DanielCusi/Aurelia-robotics-PCB/Llibreries/TMP235/README.md

[TMP235 (DBZ)](https://vendor.ultralibrarian.com/TI/embedded/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)
