DanielCusi/Aurelia-robotics-PCB/Llibreries/TPS25730D/README.md

[TPS25730DREFR](https://vendor.ultralibrarian.com/TI/embedded/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)
