DanielCusi/Aurelia-robotics-PCB/Llibreries/ul_DRV8873HPWPR/README.md

[DRV8873HPWPR](https://vendor.ultralibrarian.com/TI/embedded/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)
