DanielCusi/Aurelia-robotics-PCB/Llibreries/ul_TCA6408APWR/README.md

[TCA6408APWR](https://vendor.ultralibrarian.com/TI/embedded/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)
