DanielCusi/Aurelia-robotics-PCB/Llibreries/ul_TPS54531DDA/README.md

[TPS54531DDA](https://vendor.ultralibrarian.com/TI/embedded/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)
