DanielCusi/Aurelia-robotics-PCB/Llibreries/ul_TPS563300DRLR/README.md

[TPS563300DRLR](https://vendor.ultralibrarian.com/TI/embedded/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)
