DanielCusi/Aurelia-robotics-PCB/Alimentacio.kicad_sch

## KiCad design Alimentacio.kicad_sch (2024-10-28)

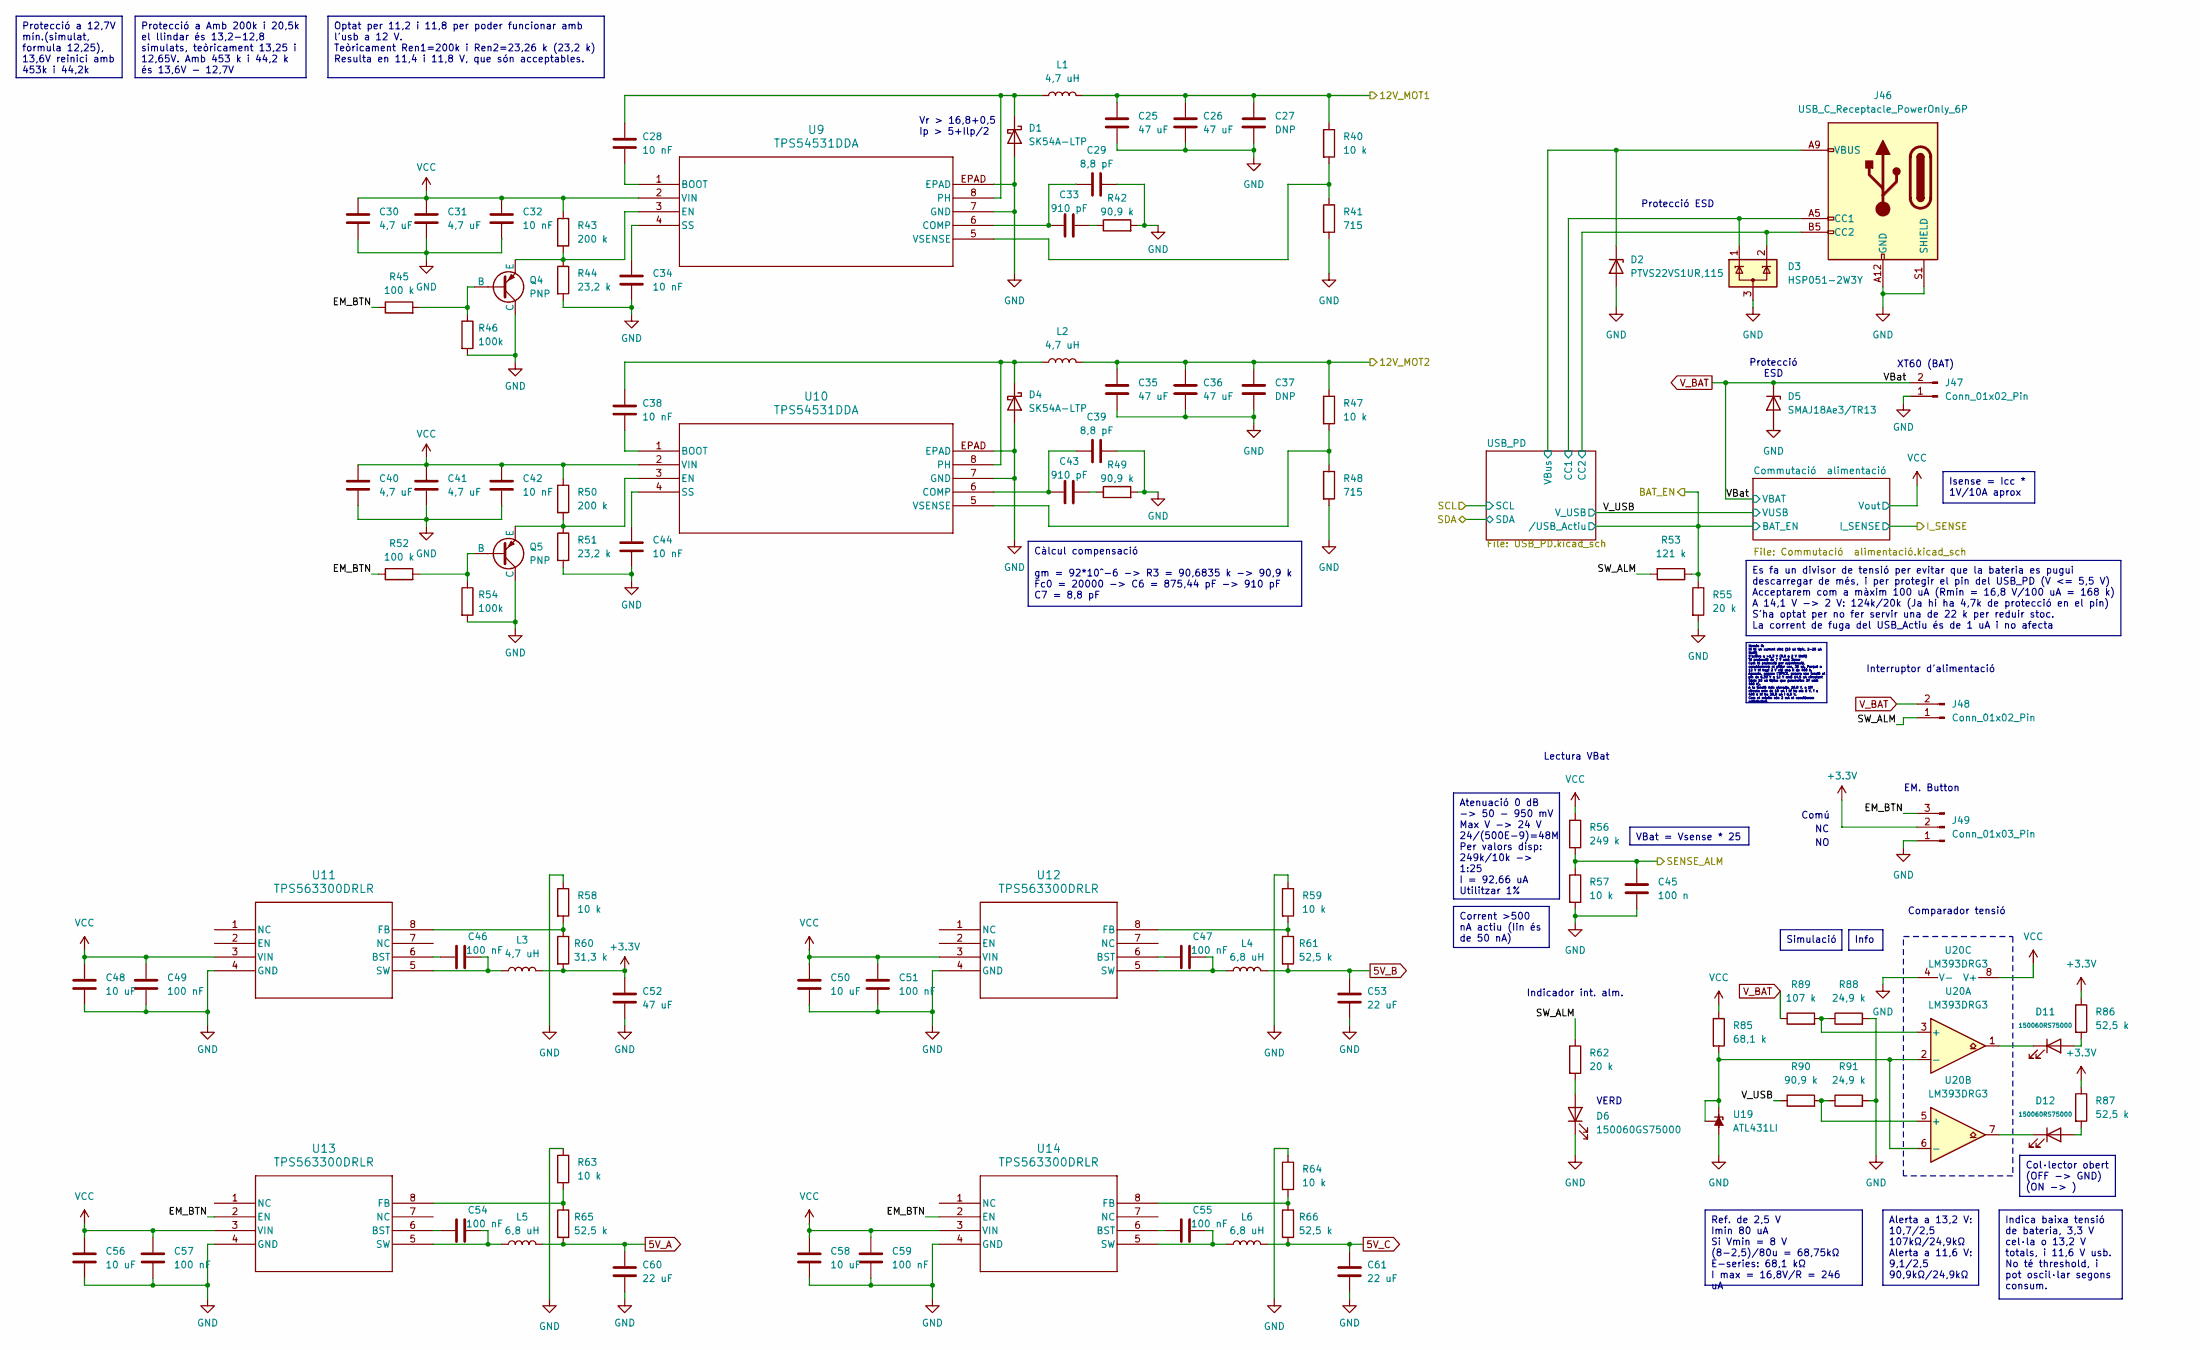
[picture p1: schematic Alimentacio.kicad_sch]

Parts:
C25, C26, C35, C36, C52: 47 uF; C_1210_3225Metric_Pad1.33x2.70mm_HandSolder
C27, C37: DNP; C_1210_3225Metric_Pad1.33x2.70mm_HandSolder
C28, C32, C34, C38, C42, C44: 10 nF; C_0603_1608Metric_Pad1.08x0.95mm_HandSolder
C29, C39: 8,8 pF; C_0603_1608Metric_Pad1.08x0.95mm_HandSolder
C30, C31, C40, C41: 4,7 uF; C_0603_1608Metric_Pad1.08x0.95mm_HandSolder
C33, C43: 910 pF; C_0603_1608Metric_Pad1.08x0.95mm_HandSolder
C45: 100 n; C_0603_1608Metric_Pad1.08x0.95mm_HandSolder
C46, C47, C49, C51, C54, C55, C57, C59: 100 nF; C_0603_1608Metric_Pad1.08x0.95mm_HandSolder
C48, C50, C56, C58: 10 uF; C_0603_1608Metric_Pad1.08x0.95mm_HandSolder
C53, C60, C61: 22 uF; C_0805_2012Metric_Pad1.18x1.45mm_HandSolder
D1, D4: SK54A-LTP; D_SMA
D2: PTVS22VS1UR,115; Nexperia_CFP3_SOD-123W
D3: HSP051-2W3Y; SOT-323_SC-70_Handsoldering
D5: SMAJ18Ae3/TR13; D_SMA_Handsoldering
D6: 150060GS75000; LED_0603_1608Metric_Pad1.05x0.95mm_HandSolder
D11, D12: 150060RS75000; LED_0603_1608Metric_Pad1.05x0.95mm_HandSolder
J46: USB_C_Receptacle_PowerOnly_6P; USB_C_6_DEALON
J47: Conn_01x02_Pin; AMASS_XT60PW-M_1x02_P7.20mm_Horizontal
J48: Conn_01x02_Pin; JST_PH_B2B-PH-K_1x02_P2.00mm_Vertical
J49: Conn_01x03_Pin; JST_PH_B3B-PH-K_1x03_P2.00mm_Vertical
L1, L2, L3: 4,7 uH; INDPM7166X300N
L4, L5, L6: 6,8 uH; INDPM7166X300N
Q4, Q5: PNP; SOT-23
R40, R47, R57, R58, R59, R63, R64: 10 k; R_0603_1608Metric_Pad0.98x0.95mm_HandSolder
R41, R48: 715; R_0603_1608Metric_Pad0.98x0.95mm_HandSolder
R42, R49, R90: 90,9 k; R_0603_1608Metric_Pad0.98x0.95mm_HandSolder
R43, R50: 200 k; R_0603_1608Metric_Pad0.98x0.95mm_HandSolder
R44, R51: 23,2 k; R_0603_1608Metric_Pad0.98x0.95mm_HandSolder
R45, R52: 100 k; R_0603_1608Metric_Pad0.98x0.95mm_HandSolder
R46, R54: 100k; R_0603_1608Metric_Pad0.98x0.95mm_HandSolder
R53: 121 k; R_0603_1608Metric_Pad0.98x0.95mm_HandSolder
R55, R62: 20 k; R_0603_1608Metric_Pad0.98x0.95mm_HandSolder
R56: 249 k; R_0603_1608Metric_Pad0.98x0.95mm_HandSolder
R60: 31,3 k; R_0603_1608Metric_Pad0.98x0.95mm_HandSolder
R61, R65, R66, R86, R87: 52,5 k; R_0603_1608Metric_Pad0.98x0.95mm_HandSolder
R85: 68,1 k; R_0603_1608Metric_Pad0.98x0.95mm_HandSolder
R88, R91: 24,9 k; R_0603_1608Metric_Pad0.98x0.95mm_HandSolder
R89: 107 k; R_0603_1608Metric_Pad0.98x0.95mm_HandSolder
U9, U10: TPS54531DDA; DDA8_3P1X2P4_TEX
U11, U12, U13, U14: TPS563300DRLR; SOT5X3-8_DRL_TEX
U19: ATL431LI; SOT-23
U20: LM393DRG3; SOIC-8_3.9x4.9mm_P1.27mm

Connections:
5V_A: C60.2, L5.2, R65.2
5V_B: C53.2, L4.2, R61.2
5V_C: C61.2, L6.2, R66.2
12V_MOT1: C25.1, C26.1, C27.1, L1.2, R40.1
12V_MOT2: C35.1, C36.1, C37.1, L2.2, R47.1
+3.3V: C52.2, J49.2, L3.2, R60.2, R86.1, R87.1
BAT_EN: R53.1, R55.1
CC1: D3.1 (K), J46.A5 (CC1)
CC2: D3.2 (K), J46.B5 (CC2)
EM_BTN: J49.3, R45.1, R52.1, U13.2 (EN), U14.2 (EN)
GND: C25.2, C26.2, C27.2, C29.2, C30.2, C31.2, C32.2, C34.2, C35.2, C36.2, C37.2, C39.2, C40.2, C41.2, C42.2, C44.2, C45.2, C48.2, C49.2, C50.2, C51.2, C52.1, C53.1, C56.2, C57.2, C58.2, C59.2, C60.1, C61.1, D1.2 (A), D2.2 (A), D3.3 (A), D4.2 (A), D5.2 (A), D6.1 (K), J46.A12 (GND), J46.B12 (GND), J46.S1 (SHIELD), J47.1, J49.1, Q4.1 (C), Q5.1 (C), R41.2, R42.2, R44.2, R46.2, R48.2, R49.2, R51.2, R54.2, R55.2, R57.2, R58.1, R59.1, R63.1, R64.1, R88.2, R91.2, U9.7 (GND), U9.EPAD, U10.7 (GND), U10.EPAD, U11.4 (GND), U12.4 (GND), U13.4 (GND), U14.4 (GND), U19.3 (A), U20.4 (V-)
unnamed: C28.1, D1.1 (K), L1.1, U9.8 (PH)
unnamed: C28.2, U9.1 (BOOT)
unnamed: C29.1, C33.1, U9.6 (COMP)
unnamed: C33.2, R42.1
unnamed: C34.1, U9.4 (SS)
unnamed: C38.1, D4.1 (K), L2.1, U10.8 (PH)
unnamed: C38.2, U10.1 (BOOT)
unnamed: C39.1, C43.1, U10.6 (COMP)
unnamed: C43.2, R49.1
unnamed: C44.1, U10.4 (SS)
unnamed: C46.1, U11.6 (BST)
unnamed: C46.2, L3.1, U11.5 (SW)
unnamed: C47.1, U12.6 (BST)
unnamed: C47.2, L4.1, U12.5 (SW)
unnamed: C54.1, U13.6 (BST)
unnamed: C54.2, L5.1, U13.5 (SW)
unnamed: C55.1, U14.6 (BST)
unnamed: C55.2, L6.1, U14.5 (SW)
unnamed: D6.2 (A), R62.2
unnamed: D11.1 (K), U20.1
unnamed: D11.2 (A), R86.2
unnamed: D12.1 (K), U20.7
unnamed: D12.2 (A), R87.2
unnamed: Q4.2 (B), R45.2, R46.1
unnamed: Q4.3 (E), R43.2, R44.1, U9.3 (EN)
unnamed: Q5.2 (B), R52.2, R54.1
unnamed: Q5.3 (E), R50.2, R51.1, U10.3 (EN)
unnamed: R40.2, R41.1, U9.5 (VSENSE)
unnamed: R47.2, R48.1, U10.5 (VSENSE)
unnamed: R58.2, R60.1, U11.8 (FB)
unnamed: R59.2, R61.1, U12.8 (FB)
unnamed: R63.2, R65.1, U13.8 (FB)
unnamed: R64.2, R66.1, U14.8 (FB)
unnamed: R85.2, U19.1 (K), U19.2 (REF), U20.2 (-), U20.6 (-)
unnamed: R88.1, R89.2, U20.3 (+)
unnamed: R90.2, R91.1, U20.5 (+)
SENSE_ALM: C45.1, R56.2, R57.1
SW_ALM: J48.1, R53.2, R62.1
VBus: D2.1 (K), J46.A9 (VBUS), J46.B9 (VBUS)
VCC: C30.1, C31.1, C32.1, C40.1, C41.1, C42.1, C48.1, C49.1, C50.1, C51.1, C56.1, C57.1, C58.1, C59.1, R43.1, R50.1, R56.1, R85.1, U9.2 (VIN), U10.2 (VIN), U11.3 (VIN), U12.3 (VIN), U13.3 (VIN), U14.3 (VIN), U20.8 (V+)
V_BAT: D5.1 (K), J47.2, J48.2, R89.1
V_USB: R90.1

Notes on the sheet:
Col·lector obert (OFF -> GND) (ON -> )
Indica baixa tensió de bateria, 3,3 V cel·la o 13,2 V totals, i 11,6 V usb. No té threshold, i pot oscil·lar segons consum.
Només R: IN té un current sink (10 uA típic, 2-25 uA límit) S'activa a >1,3 V (0,8 a 2 V límit) Té protecció de 7 V amb Zener Com té protecció per sobretensió, considerarem el pitjor cas, 25 uA. Perquè a 12 V hi hagi 2 V cal una R de 400 k. Aquesta, segons l'SPICE, genera una tensió al pin de 6,38 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
Protecció a Amb 200k i 20,5k el llindar és 13,2-12,8 simulats, teòricament 13,25 i 12,65V. Amb 453 k i 44,2 k és 13,6V - 12,7V
Es fa un divisor de tensió per evitar que la bateria es pugui descarregar de més, i per protegir el pin del USB_PD (V <= 5,5 V) Acceptarem com a màxim 100 uA (Rmin = 16,8 V/100 uA = 168 k) A 14,1 V -> 2 V: 124k/20k (Ja hi ha 4,7k de protecció en el pin) S'ha optat per no fer servir una de 22 k per 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
VBat = Vsense * 25
Optat per 11,2 i 11,8 per poder funcionar amb l'usb a 12 V. Teòricament Ren1=200k i Ren2=23,26 k (23,2 k) Resulta en 11,4 i 11,8 V, que són acceptables.
Isense = Icc * 1V/10A aprox
Protecció a 12,7V mín.(simulat, formula 12,25), 13,6V reinici amb 453k i 44,2k
Simulació
Atenuació 0 dB -> 50 - 950 mV Max V -> 24 V 24/(500E-9)=48M Per valors disp: 249k/10k -> 1:25 I = 92,66 uA Utilitzar 1%
Info
Ref. de 2,5 V Imin 80 uA Si Vmin = 8 V (8-2,5)/80u = 68,75kΩ E-series: 68,1 kΩ I max = 16,8V/R = 246 uA
Corrent >500 nA actiu (Iin és de 50 nA)
Alerta a 13,2 V: 10,7/2,5 107kΩ/24,9kΩ Alerta a 11,6 V: 9,1/2,5 90,9kΩ/24,9kΩ
Càlcul compensació gm = 92*10^-6 -> R3 = 90,6835 k -> 90,9 k Fc0 = 20000 -> C6 = 875,44 pF -> 910 pF C7 = 8,8 pF
Indicador int. alm.
XT60 (BAT)
Protecció ESD
EM. Button
Vr > 16,8+0,5 Ip > 5+Ilp/2
Protecció ESD
VERD
Comú
Lectura VBat
Comparador tensió
Interruptor d'alimentació
