DanielCusi/Aurelia-robotics-PCB/Aurelia-robotics-PCB.kicad_sch

## KiCad design Aurelia-robotics-PCB.kicad_sch (2024-10-28)

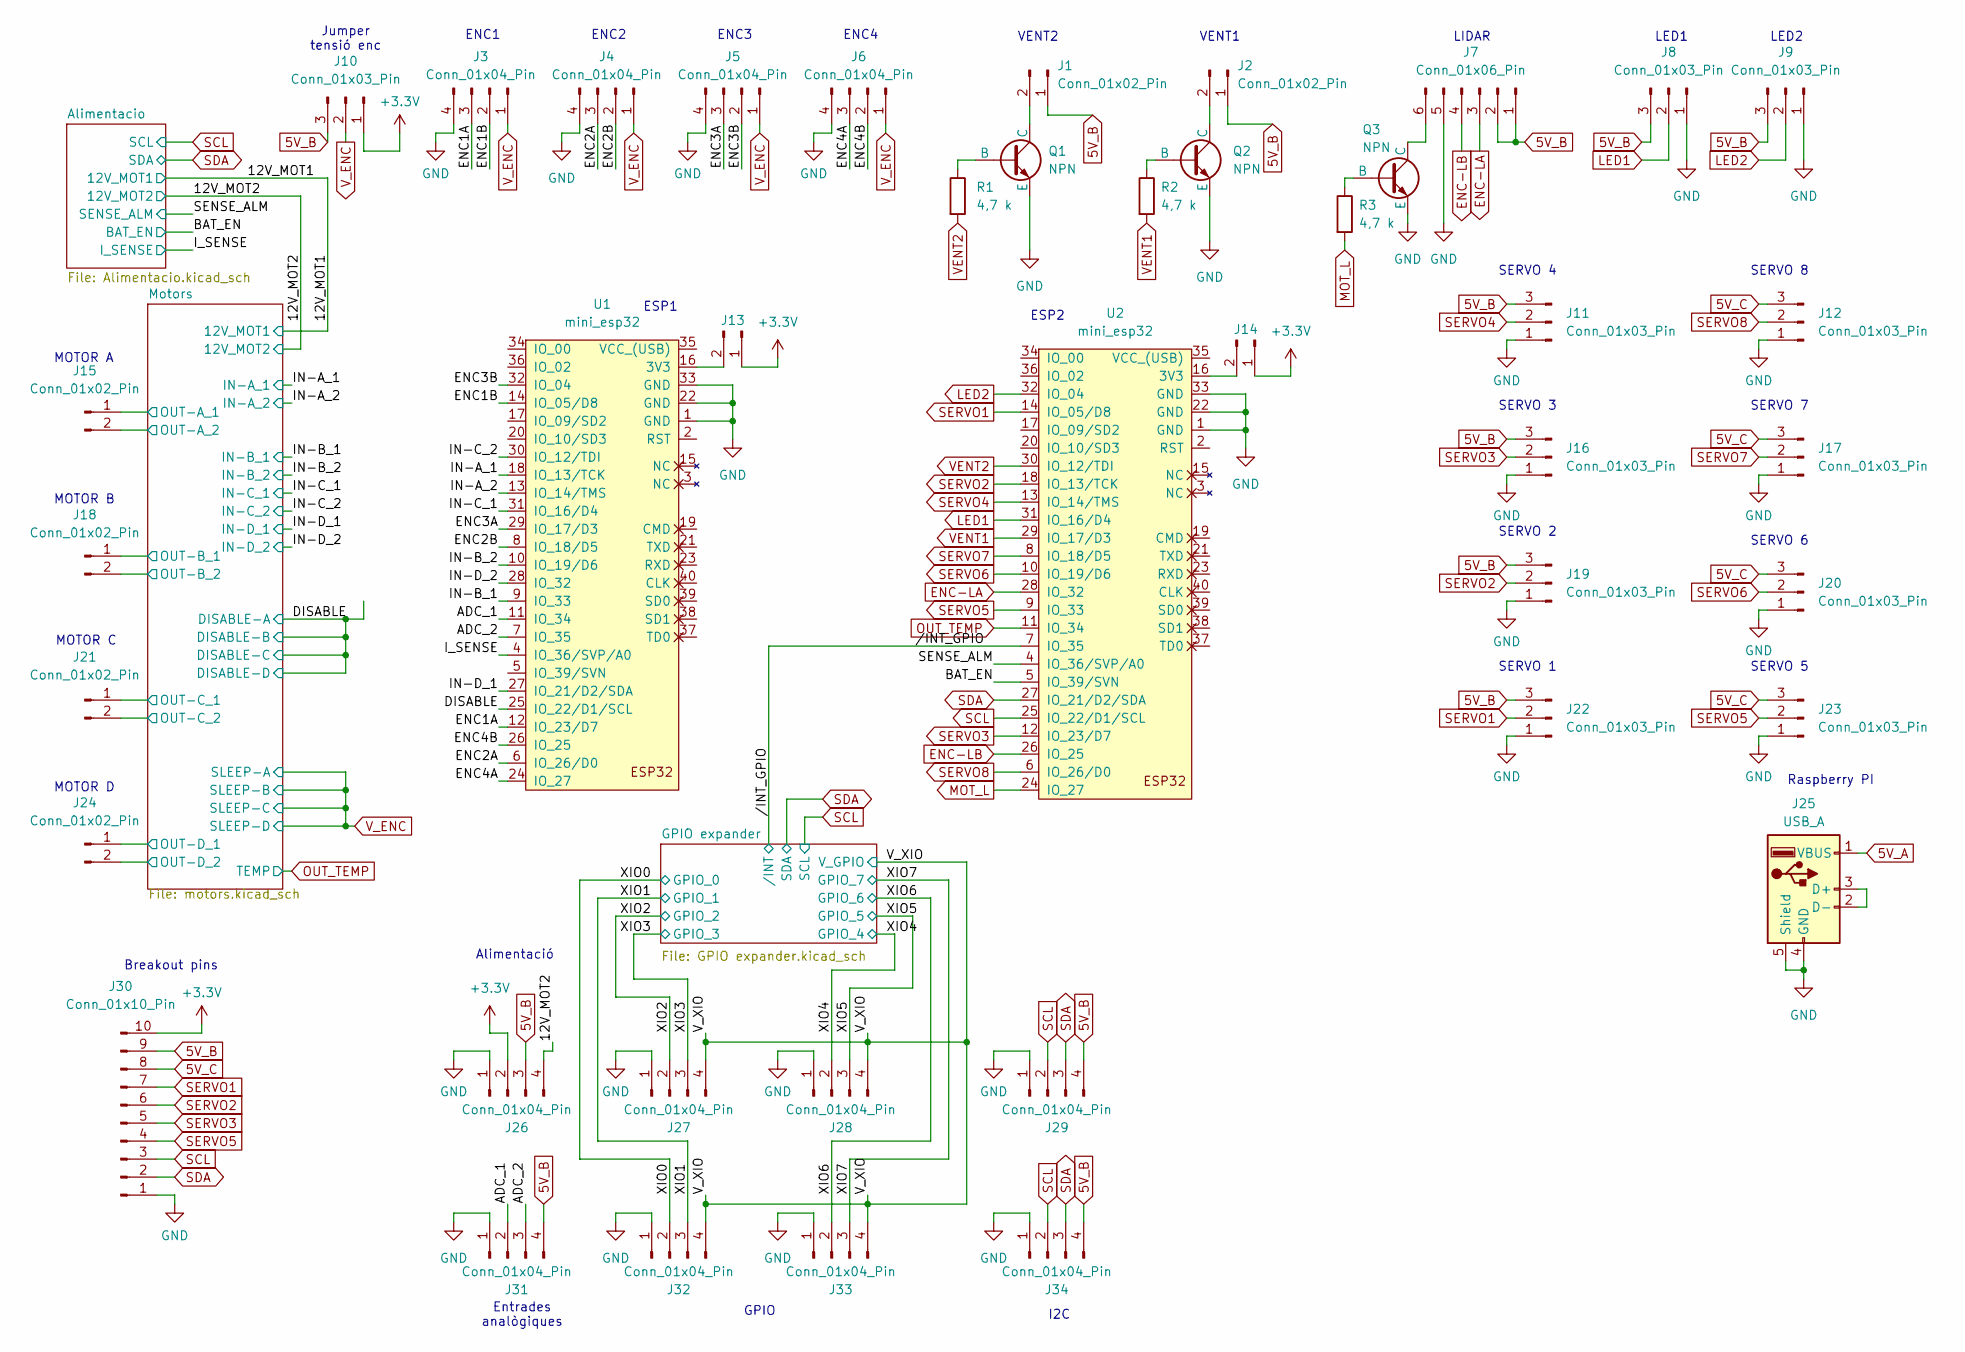
[picture p2: schematic Aurelia-robotics-PCB.kicad_sch]

Parts:
J1, J2, J15, J18, J21, J24: Conn_01x02_Pin; JST_PH_B2B-PH-K_1x02_P2.00mm_Vertical
J3, J4, J5, J6, J26, J27, J28, J29, J31, J32, J33, J34: Conn_01x04_Pin; JST_PH_B4B-PH-K_1x04_P2.00mm_Vertical
J7: Conn_01x06_Pin; JST_PH_B6B-PH-K_1x06_P2.00mm_Vertical
J8, J9, J11, J12, J16, J17, J19, J20, J22, J23: Conn_01x03_Pin; JST_PH_B3B-PH-K_1x03_P2.00mm_Vertical
J10: Conn_01x03_Pin; PinHeader_1x03_P2.54mm_Vertical
J13, J14: Conn_01x02_Pin; PinHeader_1x02_P2.54mm_Vertical
J25: USB_A; USB_A_Receptacle_GCT_USB1046
J30: Conn_01x10_Pin; PinHeader_1x10_P2.54mm_Horizontal
Q1, Q2, Q3: NPN; SOT-23
R1, R2, R3: 4,7 k; R_0603_1608Metric_Pad0.98x0.95mm_HandSolder
U1, U2: mini_esp32; ESP32_mini

Connections:
5V_A: J25.1 (VBUS)
5V_B: J1.1, J2.1, J7.1, J7.2, J8.3, J9.3, J10.3, J11.3, J16.3, J19.3, J22.3, J26.3, J29.4, J30.9, J31.4, J34.4
5V_C: J12.3, J17.3, J20.3, J23.3, J30.8
12V_MOT2: J26.4
+3.3V: J10.1, J13.1, J14.1, J26.2, J30.10
ADC_1: J31.2, U1.11 (IO_34)
ADC_2: J31.3, U1.7 (IO_35)
BAT_EN: U2.5 (IO_39/SVN)
DISABLE: U1.25 (IO_22/D1/SCL)
ENC1A: J3.3, U1.12 (IO_23/D7)
ENC1B: J3.2, U1.14 (IO_05/D8)
ENC2A: J4.3, U1.6 (IO_26/D0)
ENC2B: J4.2, U1.8 (IO_18/D5)
ENC3A: J5.3, U1.29 (IO_17/D3)
ENC3B: J5.2, U1.32 (IO_04)
ENC4A: J6.3, U1.24 (IO_27)
ENC4B: J6.2, U1.26 (IO_25)
ENC-LA: J7.3, U2.28 (IO_32)
ENC-LB: J7.4, U2.26 (IO_25)
GND: J3.4, J4.4, J5.4, J6.4, J7.5, J8.1, J9.1, J11.1, J12.1, J16.1, J17.1, J19.1, J20.1, J22.1, J23.1, J25.4 (GND), J25.5 (Shield), J26.1, J27.1, J28.1, J29.1, J30.1, J31.1, J32.1, J33.1, J34.1, Q1.3 (E), Q2.3 (E), Q3.3 (E), U1.1 (GND), U1.22 (GND), U1.33 (GND), U2.1 (GND), U2.22 (GND), U2.33 (GND)
IN-A_1: U1.18 (IO_13/TCK)
IN-A_2: U1.13 (IO_14/TMS)
IN-B_1: U1.9 (IO_33)
IN-B_2: U1.10 (IO_19/D6)
IN-C_1: U1.31 (IO_16/D4)
IN-C_2: U1.30 (IO_12/TDI)
IN-D_1: U1.27 (IO_21/D2/SDA)
IN-D_2: U1.28 (IO_32)
I_SENSE: U1.4 (IO_36/SVP/A0)
LED1: J8.2, U2.31 (IO_16/D4)
LED2: J9.2, U2.32 (IO_04)
MOT_L: R3.2, U2.24 (IO_27)
unnamed: J1.2, Q1.1 (C)
unnamed: J2.2, Q2.1 (C)
unnamed: J7.6, Q3.1 (C)
unnamed: J13.2, U1.16 (3V3)
unnamed: J14.2, U2.16 (3V3)
unnamed: J25.2 (D-), J25.3 (D+)
unnamed: Q1.2 (B), R1.1
unnamed: Q2.2 (B), R2.1
unnamed: Q3.2 (B), R3.1
OUT-A_1: J15.1
OUT-A_2: J15.2
OUT-B_1: J18.1
OUT-B_2: J18.2
OUT-C_1: J21.1
OUT-C_2: J21.2
OUT-D_1: J24.1
OUT-D_2: J24.2
OUT_TEMP: U2.11 (IO_34)
SCL: J29.2, J30.3, J34.2, U2.25 (IO_22/D1/SCL)
SDA: J29.3, J30.2, J34.3, U2.27 (IO_21/D2/SDA)
SENSE_ALM: U2.4 (IO_36/SVP/A0)
SERVO1: J22.2, J30.7, U2.14 (IO_05/D8)
SERVO2: J19.2, J30.6, U2.18 (IO_13/TCK)
SERVO3: J16.2, J30.5, U2.12 (IO_23/D7)
SERVO4: J11.2, U2.13 (IO_14/TMS)
SERVO5: J23.2, J30.4, U2.9 (IO_33)
SERVO6: J20.2, U2.10 (IO_19/D6)
SERVO7: J17.2, U2.8 (IO_18/D5)
SERVO8: J12.2, U2.6 (IO_26/D0)
VENT1: R2.2, U2.29 (IO_17/D3)
VENT2: R1.2, U2.30 (IO_12/TDI)
V_ENC: J3.1, J4.1, J5.1, J6.1, J10.2
V_XIO: J27.4, J28.4, J32.4, J33.4
XIO0: J32.2
XIO1: J32.3
XIO2: J27.2
XIO3: J27.3
XIO4: J28.2
XIO5: J28.3
XIO6: J33.2
XIO7: J33.3
/INT_GPIO: U2.7 (IO_35)

Notes on the sheet:
LED2
SERVO 4
MOTOR D
ESP2
ESP1
LED1
SERVO 8
SERVO 7
GPIO
SERVO 6
LIDAR
ENC3
ENC4
Entrades analògiques
ENC2
SERVO 1
MOTOR C
ENC1
Alimentació
MOTOR B
VENT1
Raspberry PI
Jumper tensió enc
I2C
SERVO 3
MOTOR A
SERVO 2
VENT2
Breakout pins
SERVO 5
