DanielCusi/Aurelia-robotics-PCB/Alimentacio.kicad_sch

## KiCad design Commutació alimentació.kicad_sch

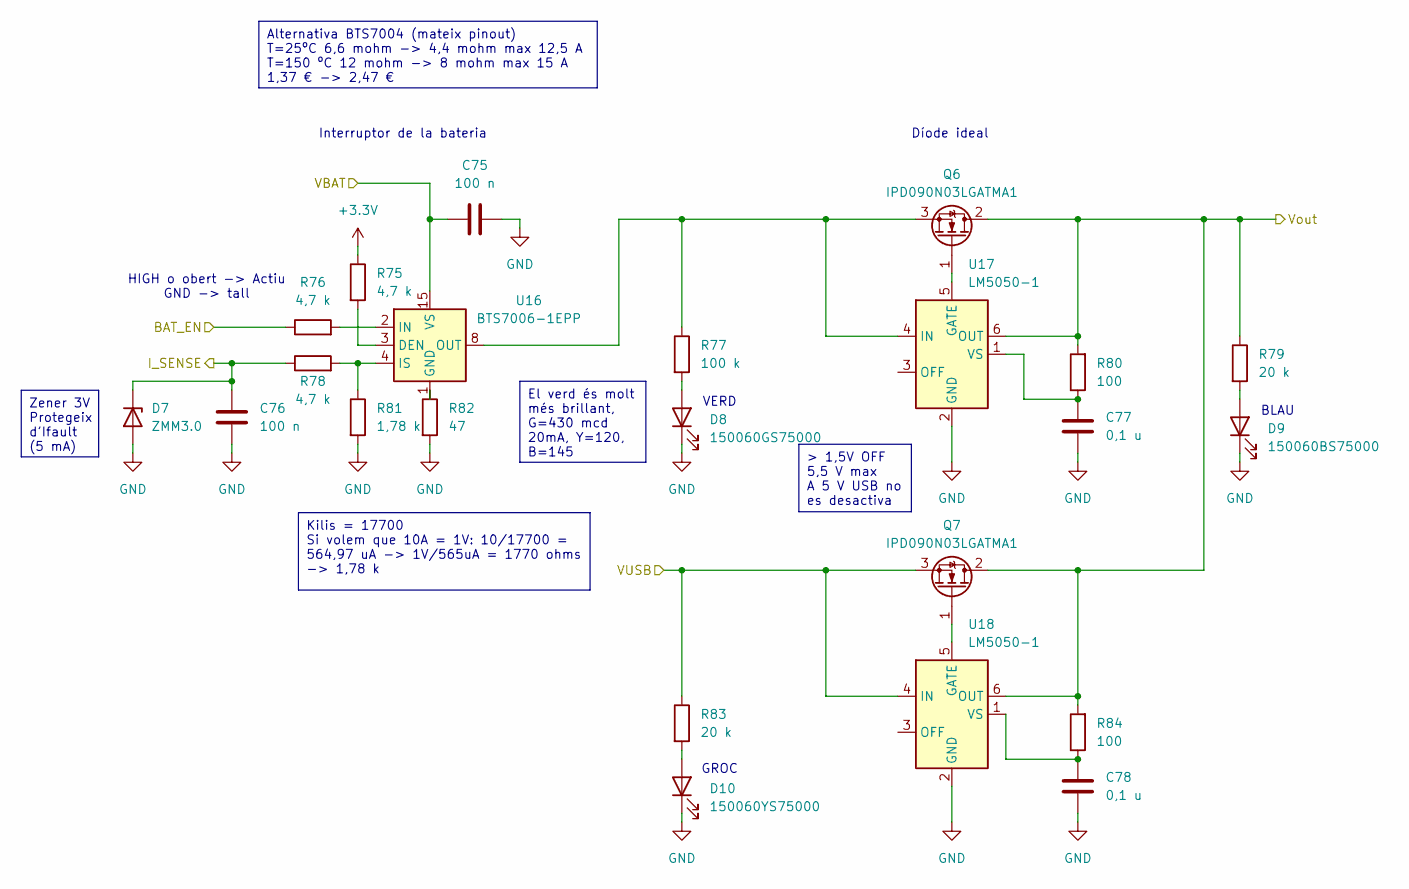
[picture p3: schematic Commutació alimentació.kicad_sch]

Parts:
C75, C76: 100 n; C_0603_1608Metric_Pad1.08x0.95mm_HandSolder
C77, C78: 0,1 u; C_0603_1608Metric_Pad1.08x0.95mm_HandSolder
D7: ZMM3.0; D_MiniMELF
D8: 150060GS75000; LED_0603_1608Metric_Pad1.05x0.95mm_HandSolder
D9: 150060BS75000; LED_0603_1608Metric_Pad1.05x0.95mm_HandSolder
D10: 150060YS75000; LED_0603_1608Metric_Pad1.05x0.95mm_HandSolder
Q6, Q7: IPD090N03LGATMA1; TO-252-2
R75, R76, R78: 4,7 k; R_0603_1608Metric_Pad0.98x0.95mm_HandSolder
R77: 100 k; R_0603_1608Metric_Pad0.98x0.95mm_HandSolder
R79, R83: 20 k; R_0603_1608Metric_Pad0.98x0.95mm_HandSolder
R80, R84: 100; R_0603_1608Metric_Pad0.98x0.95mm_HandSolder
R81: 1,78 k; R_0603_1608Metric_Pad0.98x0.95mm_HandSolder
R82: 47; R_0603_1608Metric_Pad0.98x0.95mm_HandSolder
U16: BTS7006-1EPP; Infineon_PG-TSDSO-14-22
U17, U18: LM5050-1; TSOT-23-6

Connections:
+3.3V: R75.1
BAT_EN: R76.1
GND: C75.2, C76.2, C77.2, C78.2, D7.2 (A), D8.1 (K), D9.1 (K), D10.1 (K), R81.2, R82.2, U17.2 (GND), U18.2 (GND)
I_SENSE: C76.1, D7.1 (K), R78.1
unnamed: C77.1, R80.1, U17.1 (VS)
unnamed: C78.1, R84.1, U18.1 (VS)
unnamed: D8.2 (A), R77.2
unnamed: D9.2 (A), R79.2
unnamed: D10.2 (A), R83.2
unnamed: Q6.1 (G), U17.5 (GATE)
unnamed: Q6.3 (S), R77.1, U16.8 (OUT), U16.9 (OUT), U16.10 (OUT), U16.12 (OUT), U16.13 (OUT), U16.14 (OUT), U17.4 (IN)
unnamed: Q7.1 (G), U18.5 (GATE)
unnamed: R75.2, U16.3 (DEN)
unnamed: R76.2, U16.2 (IN)
unnamed: R78.2, R81.1, U16.4 (IS)
unnamed: R82.1, U16.1 (GND)
VBAT: C75.1, U16.15 (VS)
VUSB: Q7.3 (S), R83.1, U18.4 (IN)
Vout: Q6.2 (D), Q7.2 (D), R79.1, R80.2, R84.2, U17.6 (OUT), U18.6 (OUT)

Notes on the sheet:
Alternativa BTS7004 (mateix pinout) T=25ºC 6,6 mohm -> 4,4 mohm max 12,5 A T=150 ºC 12 mohm -> 8 mohm max 15 A 1,37 € -> 2,47 €
> 1,5V OFF 5,5 V max A 5 V USB no es desactiva
Zener 3V Protegeix d'Ifault (5 mA)
El verd és molt més brillant, G=430 mcd 20mA, Y=120, B=145
Kilis = 17700 Si volem que 10A = 1V: 10/17700 = 564,97 uA -> 1V/565uA = 1770 ohms -> 1,78 k
BLAU
VERD
Interruptor de la bateria
Díode ideal
GROC
HIGH o obert -> Actiu GND -> tall
