DanielCusi/Aurelia-robotics-PCB/GPIO expander.kicad_sch

## KiCad design GPIO expander.kicad_sch (2024-10-28)

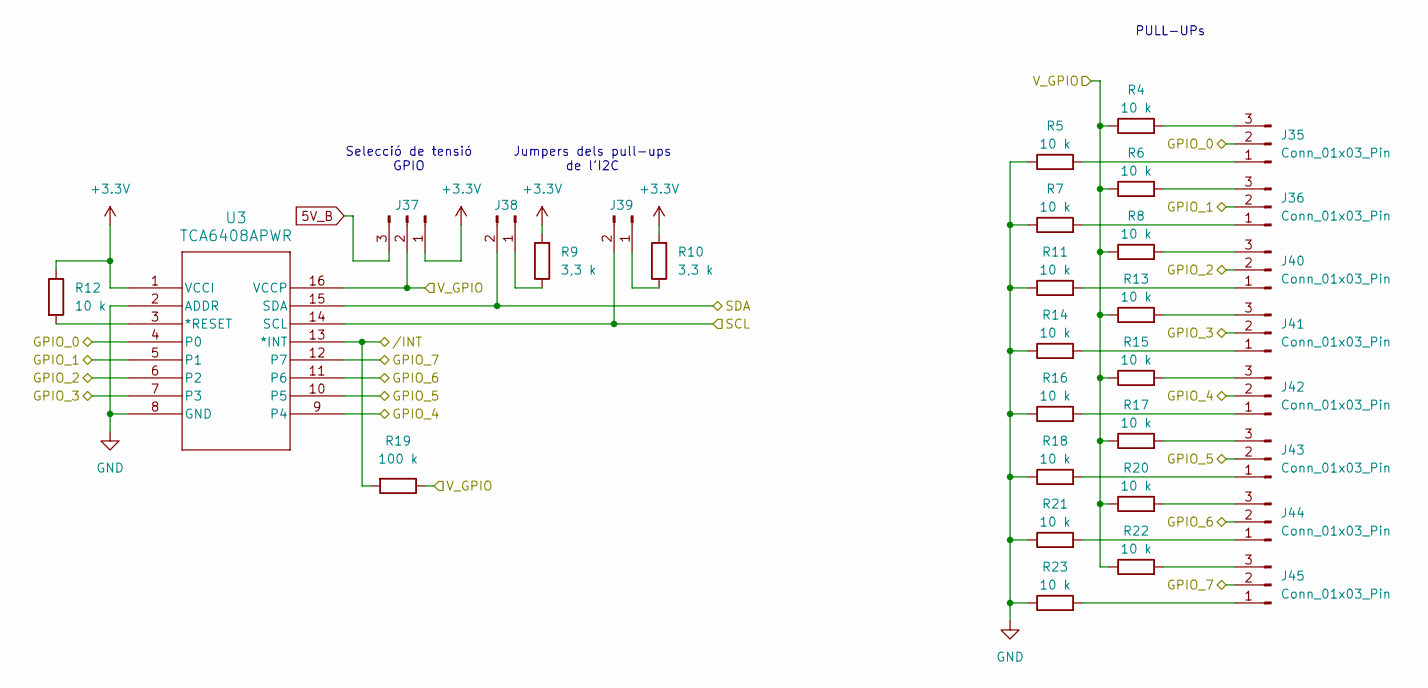
[picture p4: schematic GPIO expander.kicad_sch]

Parts:
J35, J36, J37, J40, J41, J42, J43, J44, J45: Conn_01x03_Pin; PinHeader_1x03_P2.54mm_Vertical
J38, J39: Conn_01x02_Pin; PinHeader_1x02_P2.54mm_Vertical
R4, R5, R6, R7, R8, R11, R12, R13, R14, R15, R16, R17, R18, R20, R21, R22, R23: 10 k; R_0603_1608Metric_Pad0.98x0.95mm_HandSolder
R9, R10: 3,3 k; R_0603_1608Metric_Pad0.98x0.95mm_HandSolder
R19: 100 k; R_0603_1608Metric_Pad0.98x0.95mm_HandSolder
U3: TCA6408APWR; PW16

Connections:
5V_B: J37.3
+3.3V: J37.1, R9.2, R10.2, R12.1, U3.1 (VCCI)
GND: R5.1, R7.1, R11.1, R14.1, R16.1, R18.1, R21.1, R23.1, U3.2 (ADDR), U3.8 (GND)
GPIO_0: J35.2, U3.4 (P0)
GPIO_1: J36.2, U3.5 (P1)
GPIO_2: J40.2, U3.6 (P2)
GPIO_3: J41.2, U3.7 (P3)
GPIO_4: J42.2, U3.9 (P4)
GPIO_5: J43.2, U3.10 (P5)
GPIO_6: J44.2, U3.11 (P6)
GPIO_7: J45.2, U3.12 (P7)
unnamed: J35.1, R5.2
unnamed: J35.3, R4.2
unnamed: J36.1, R7.2
unnamed: J36.3, R6.2
unnamed: J38.1, R9.1
unnamed: J39.1, R10.1
unnamed: J40.1, R11.2
unnamed: J40.3, R8.2
unnamed: J41.1, R14.2
unnamed: J41.3, R13.2
unnamed: J42.1, R16.2
unnamed: J42.3, R15.2
unnamed: J43.1, R18.2
unnamed: J43.3, R17.2
unnamed: J44.1, R21.2
unnamed: J44.3, R20.2
unnamed: J45.1, R23.2
unnamed: J45.3, R22.2
unnamed: R12.2, U3.3 (*RESET)
SCL: J39.2, U3.14 (SCL)
SDA: J38.2, U3.15 (SDA)
V_GPIO: J37.2, R4.1, R6.1, R8.1, R13.1, R15.1, R17.1, R19.1, R20.1, R22.1, U3.16 (VCCP)
/INT: R19.2, U3.13 (*INT)

Notes on the sheet:
Jumpers dels pull-ups de l'I2C
PULL-UPs
Selecció de tensió GPIO
