DanielCusi/Aurelia-robotics-PCB/USB_PD.kicad_sch

## KiCad design USB_PD.kicad_sch (2024-10-28)

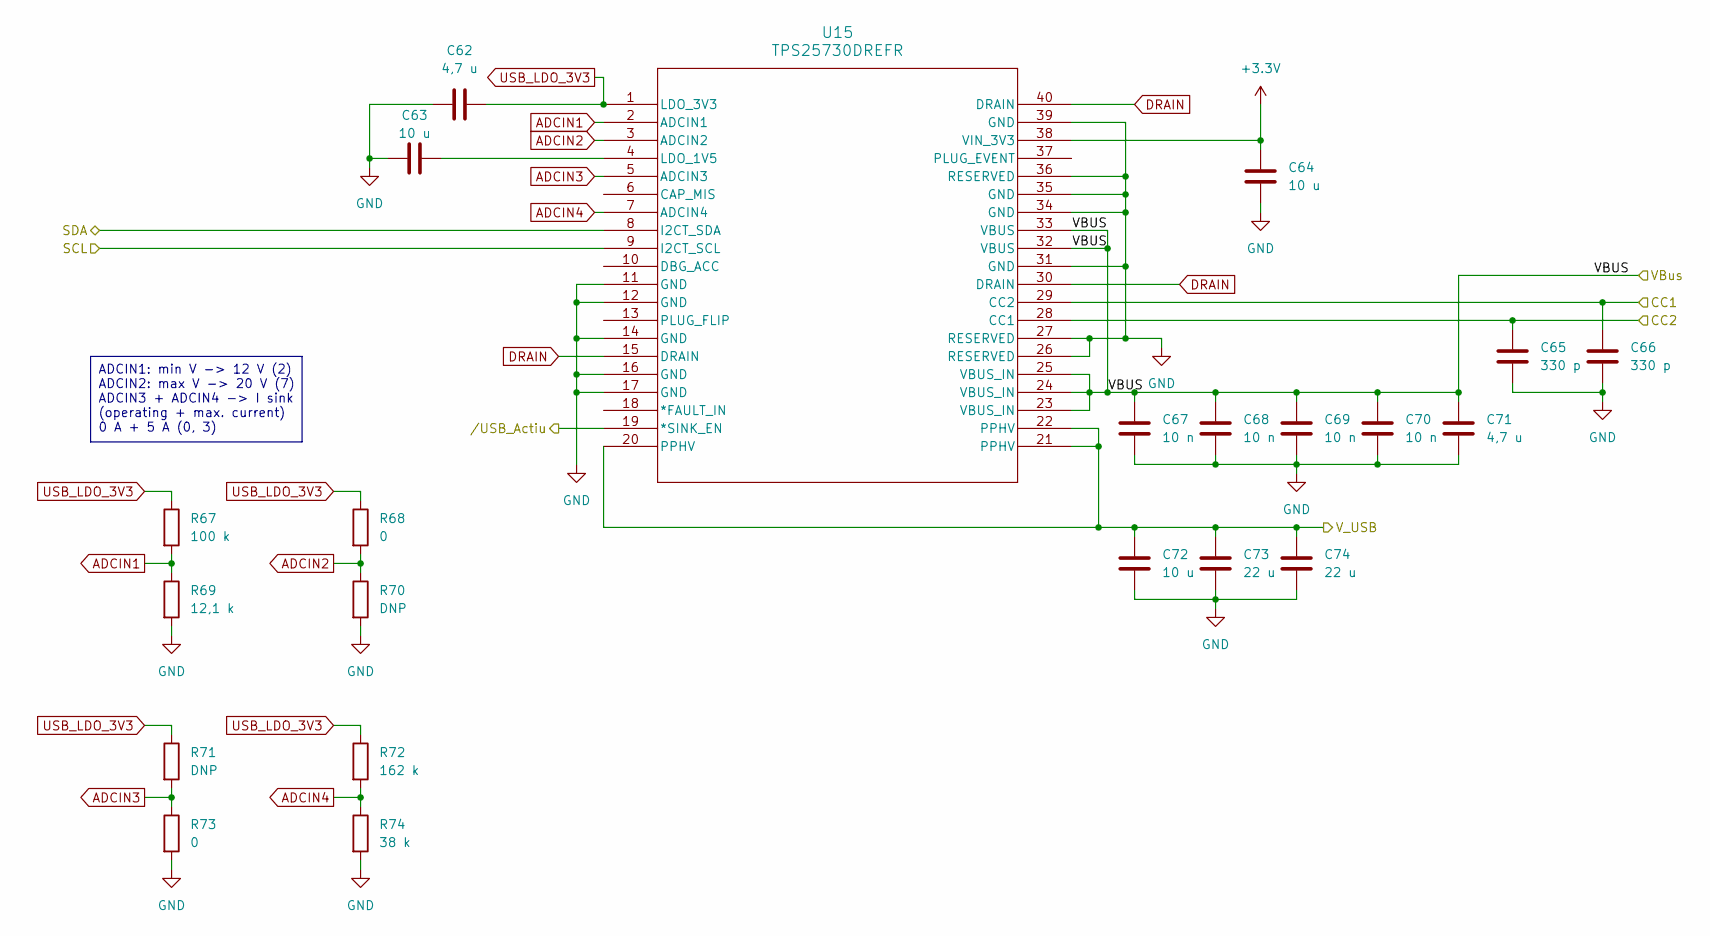
[picture p5: schematic USB_PD.kicad_sch]

Parts:
C62, C71: 4,7 u; C_0603_1608Metric_Pad1.08x0.95mm_HandSolder
C63, C64, C72: 10 u; C_0603_1608Metric_Pad1.08x0.95mm_HandSolder
C65, C66: 330 p; C_0603_1608Metric_Pad1.08x0.95mm_HandSolder
C67, C68, C69, C70: 10 n; C_0603_1608Metric_Pad1.08x0.95mm_HandSolder
C73, C74: 22 u; C_0805_2012Metric_Pad1.18x1.45mm_HandSolder
R67: 100 k; R_0603_1608Metric_Pad0.98x0.95mm_HandSolder
R68, R73: 0; R_0603_1608Metric_Pad0.98x0.95mm_HandSolder
R69: 12,1 k; R_0603_1608Metric_Pad0.98x0.95mm_HandSolder
R70, R71: DNP; R_0603_1608Metric_Pad0.98x0.95mm_HandSolder
R72: 162 k; R_0603_1608Metric_Pad0.98x0.95mm_HandSolder
R74: 38 k; R_0603_1608Metric_Pad0.98x0.95mm_HandSolder
U15: TPS25730DREFR; WQFN38_REF_TEX

Connections:
+3.3V: C64.2, U15.38 (VIN_3V3)
ADCIN1: R67.2, R69.1, U15.2 (ADCIN1)
ADCIN2: R68.2, R70.1, U15.3 (ADCIN2)
ADCIN3: R71.2, R73.1, U15.5 (ADCIN3)
ADCIN4: R72.2, R74.1, U15.7 (ADCIN4)
CC1: C66.1, U15.29 (CC2)
CC2: C65.1, U15.28 (CC1)
DRAIN: U15.15 (DRAIN), U15.30 (DRAIN), U15.40 (DRAIN)
GND: C62.1, C63.2, C64.1, C65.2, C66.2, C67.2, C68.2, C69.2, C70.2, C71.2, C72.2, C73.2, C74.2, R69.2, R70.2, R73.2, R74.2, U15.11 (GND), U15.12 (GND), U15.14 (GND), U15.16 (GND), U15.17 (GND), U15.26 (RESERVED), U15.27 (RESERVED), U15.31 (GND), U15.34 (GND), U15.35 (GND), U15.36 (RESERVED), U15.39 (GND)
unnamed: C63.1, U15.4 (LDO_1V5)
SCL: U15.9 (I2CT_SCL)
SDA: U15.8 (I2CT_SDA)
USB_LDO_3V3: C62.2, R67.1, R68.1, R71.1, R72.1, U15.1 (LDO_3V3)
VBus: C67.1, C68.1, C69.1, C70.1, C71.1, U15.23 (VBUS_IN), U15.24 (VBUS_IN), U15.25 (VBUS_IN), U15.32 (VBUS), U15.33 (VBUS)
V_USB: C72.1, C73.1, C74.1, U15.20 (PPHV), U15.21 (PPHV), U15.22 (PPHV)
/USB_Actiu: U15.19 (*SINK_EN)

Notes on the sheet:
ADCIN1: min V -> 12 V (2) ADCIN2: max V -> 20 V (7) ADCIN3 + ADCIN4 -> I sink (operating + max. current) 0 A + 5 A (0, 3)
