DanielCusi/Aurelia-robotics-PCB/motors.kicad_sch

## KiCad design motors.kicad_sch (2024-10-28)

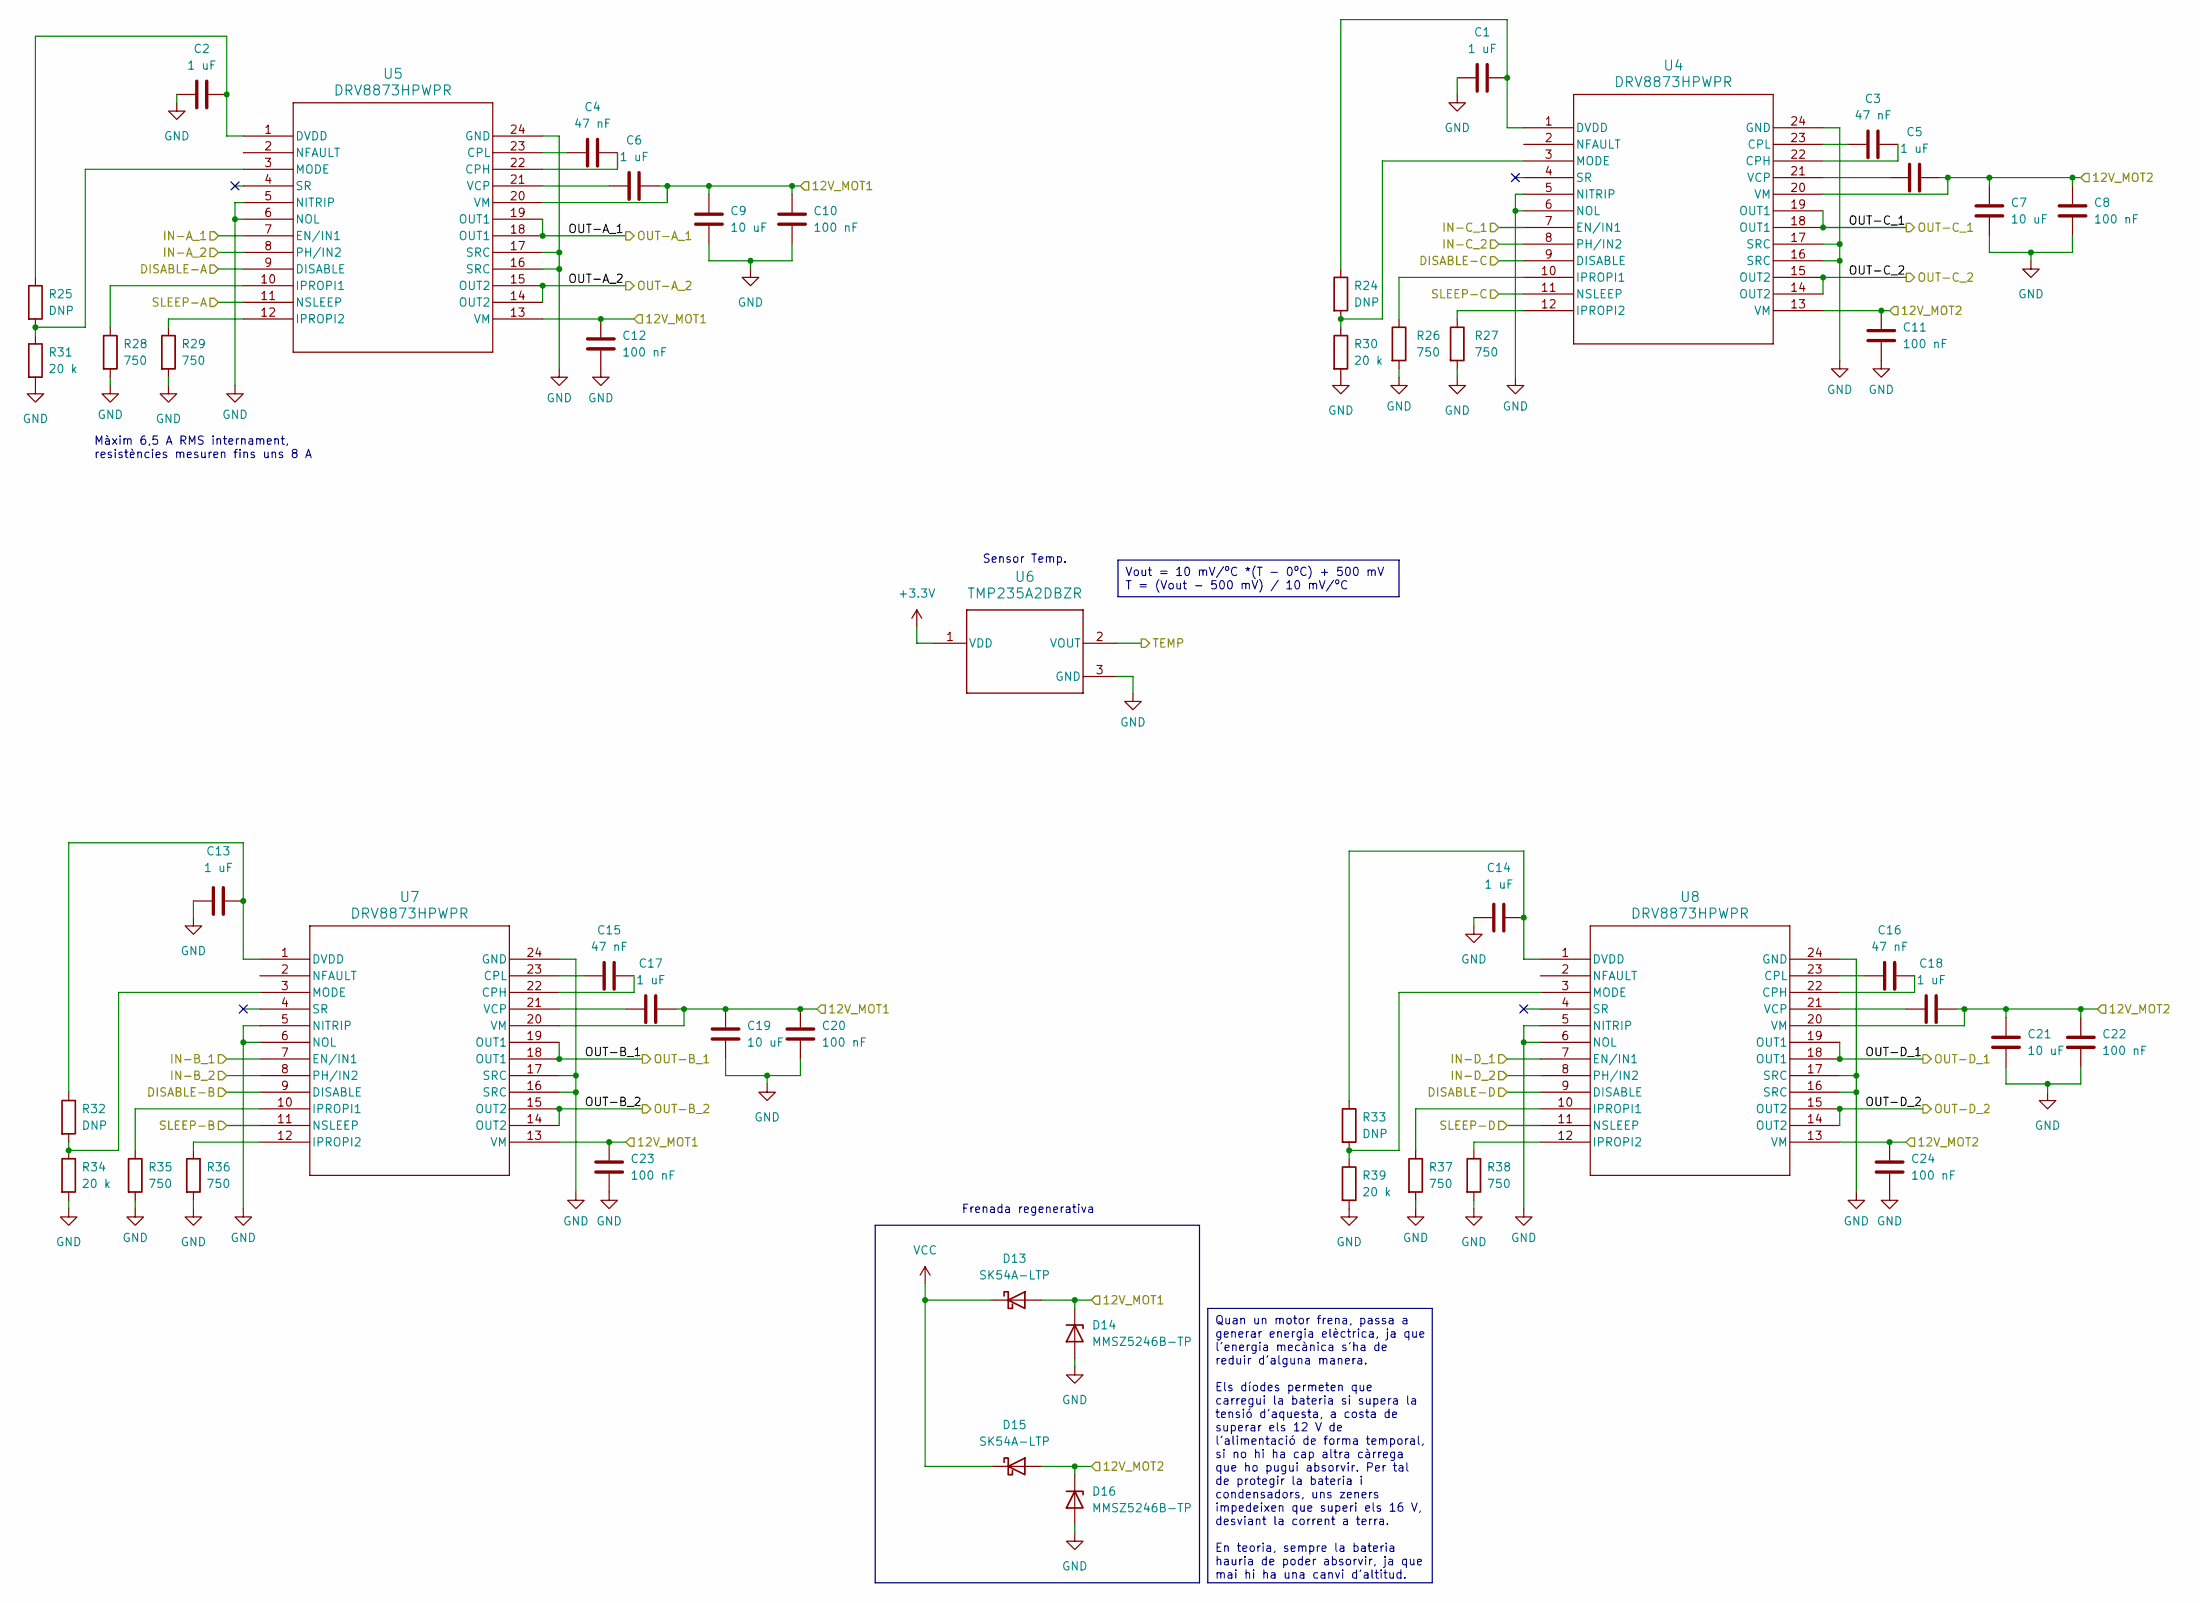
[picture p6: schematic motors.kicad_sch]

Parts:
C1, C2, C5, C6, C13, C14, C17, C18: 1 uF; C_0603_1608Metric_Pad1.08x0.95mm_HandSolder
C3, C4, C15, C16: 47 nF; C_0603_1608Metric_Pad1.08x0.95mm_HandSolder
C7, C9, C19, C21: 10 uF; C_0603_1608Metric_Pad1.08x0.95mm_HandSolder
C8, C10, C11, C12, C20, C22, C23, C24: 100 nF; C_0603_1608Metric_Pad1.08x0.95mm_HandSolder
D13, D15: SK54A-LTP; D_SMA
D14, D16: MMSZ5246B-TP; D_SOD-123
R24, R25, R32, R33: DNP; R_0603_1608Metric_Pad0.98x0.95mm_HandSolder
R26, R27, R28, R29, R35, R36, R37, R38: 750; R_0603_1608Metric_Pad0.98x0.95mm_HandSolder
R30, R31, R34, R39: 20 k; R_0603_1608Metric_Pad0.98x0.95mm_HandSolder
U4, U5, U7, U8: DRV8873HPWPR; PWP24_TEX
U6: TMP235A2DBZR; DBZ0003A-IPC_A

Connections:
12V_MOT1: C6.2, C9.1, C10.1, C12.1, C17.2, C19.1, C20.1, C23.1, D13.2 (A), D14.1 (K), U5.13 (VM), U5.20 (VM), U7.13 (VM), U7.20 (VM)
12V_MOT2: C5.2, C7.1, C8.1, C11.1, C18.2, C21.1, C22.1, C24.1, D15.2 (A), D16.1 (K), U4.13 (VM), U4.20 (VM), U8.13 (VM), U8.20 (VM)
+3.3V: U6.1 (VDD)
DISABLE-A: U5.9 (DISABLE)
DISABLE-B: U7.9 (DISABLE)
DISABLE-C: U4.9 (DISABLE)
DISABLE-D: U8.9 (DISABLE)
GND: C1.1, C2.1, C7.2, C8.2, C9.2, C10.2, C11.2, C12.2, C13.1, C14.1, C19.2, C20.2, C21.2, C22.2, C23.2, C24.2, D14.2 (A), D16.2 (A), R26.2, R27.2, R28.2, R29.2, R30.2, R31.2, R34.2, R35.2, R36.2, R37.2, R38.2, R39.2, U4.5 (NITRIP), U4.6 (NOL), U4.16 (SRC), U4.17 (SRC), U4.24 (GND), U5.5 (NITRIP), U5.6 (NOL), U5.16 (SRC), U5.17 (SRC), U5.24 (GND), U6.3 (GND), U7.5 (NITRIP), U7.6 (NOL), U7.16 (SRC), U7.17 (SRC), U7.24 (GND), U8.5 (NITRIP), U8.6 (NOL), U8.16 (SRC), U8.17 (SRC), U8.24 (GND)
IN-A_1: U5.7 (EN/IN1)
IN-A_2: U5.8 (PH/IN2)
IN-B_1: U7.7 (EN/IN1)
IN-B_2: U7.8 (PH/IN2)
IN-C_1: U4.7 (EN/IN1)
IN-C_2: U4.8 (PH/IN2)
IN-D_1: U8.7 (EN/IN1)
IN-D_2: U8.8 (PH/IN2)
unnamed: C1.2, R24.1, U4.1 (DVDD)
unnamed: C2.2, R25.1, U5.1 (DVDD)
unnamed: C3.1, U4.23 (CPL)
unnamed: C3.2, U4.22 (CPH)
unnamed: C4.1, U5.23 (CPL)
unnamed: C4.2, U5.22 (CPH)
unnamed: C5.1, U4.21 (VCP)
unnamed: C6.1, U5.21 (VCP)
unnamed: C13.2, R32.1, U7.1 (DVDD)
unnamed: C14.2, R33.1, U8.1 (DVDD)
unnamed: C15.1, U7.23 (CPL)
unnamed: C15.2, U7.22 (CPH)
unnamed: C16.1, U8.23 (CPL)
unnamed: C16.2, U8.22 (CPH)
unnamed: C17.1, U7.21 (VCP)
unnamed: C18.1, U8.21 (VCP)
unnamed: R24.2, R30.1, U4.3 (MODE)
unnamed: R25.2, R31.1, U5.3 (MODE)
unnamed: R26.1, U4.10 (IPROPI1)
unnamed: R27.1, U4.12 (IPROPI2)
unnamed: R28.1, U5.10 (IPROPI1)
unnamed: R29.1, U5.12 (IPROPI2)
unnamed: R32.2, R34.1, U7.3 (MODE)
unnamed: R33.2, R39.1, U8.3 (MODE)
unnamed: R35.1, U7.10 (IPROPI1)
unnamed: R36.1, U7.12 (IPROPI2)
unnamed: R37.1, U8.10 (IPROPI1)
unnamed: R38.1, U8.12 (IPROPI2)
OUT-A_1: U5.18 (OUT1), U5.19 (OUT1)
OUT-A_2: U5.14 (OUT2), U5.15 (OUT2)
OUT-B_1: U7.18 (OUT1), U7.19 (OUT1)
OUT-B_2: U7.14 (OUT2), U7.15 (OUT2)
OUT-C_1: U4.18 (OUT1), U4.19 (OUT1)
OUT-C_2: U4.14 (OUT2), U4.15 (OUT2)
OUT-D_1: U8.18 (OUT1), U8.19 (OUT1)
OUT-D_2: U8.14 (OUT2), U8.15 (OUT2)
SLEEP-A: U5.11 (NSLEEP)
SLEEP-B: U7.11 (NSLEEP)
SLEEP-C: U4.11 (NSLEEP)
SLEEP-D: U8.11 (NSLEEP)
TEMP: U6.2 (VOUT)
VCC: D13.1 (K), D15.1 (K)

Notes on the sheet:
Vout = 10 mV/ºC *(T - 0ºC) + 500 mV T = (Vout - 500 mV) / 10 mV/ºC
Quan un motor frena, passa a generar energia elèctrica, ja que l'energia mecànica s'ha de reduir d'alguna manera. Els díodes permeten que carregui la bateria si supera la tensió d'aquesta, a costa de superar els 12 V de l'alimentació de forma temporal, si no hi ha cap altra càrrega que ho pugui abs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
Frenada regenerativa
Sensor Temp.
Màxim 6,5 A RMS internament, resistències mesuren fins uns 8 A
